Saur0o0n/MosquitoKiller/(commit log)

2021-06-09 Fixed schematic (more resitors ;) ), fixed sketch for not booting nano from external power
    [MosquitoKiller.ino]
2021-06-10 Add menu button with short/long press - long press disables audio
    [MosquitoKiller.ino]
2021-06-12 Updated wiring documentation, introduced combo kills and code cleanup
2021-06-13 A lot of code changes and some schematic (new transistor for button), updated manual
2021-06-13 Normalized sounds, added sentences, fixed discharge count (again), introduced working combo kills
    [MosquitoKiller.ino]
2021-06-14 Fixed all known errors - first release of fully functional MosquitKiller :)
    [MosquitoKiller.ino]
2021-06-15 Changed player mode (new player every zap button release), short press changes volume, long disables/enables it
    [MosquitoKiller.ino]
2021-06-16 Add step-up board
2021-06-16 Add link to printable case
